ORT-MECATRONICA/TP-Integrador-Mastrangelo-Wiemeyer-Martos-Bae/Presentacion huerta.pdf

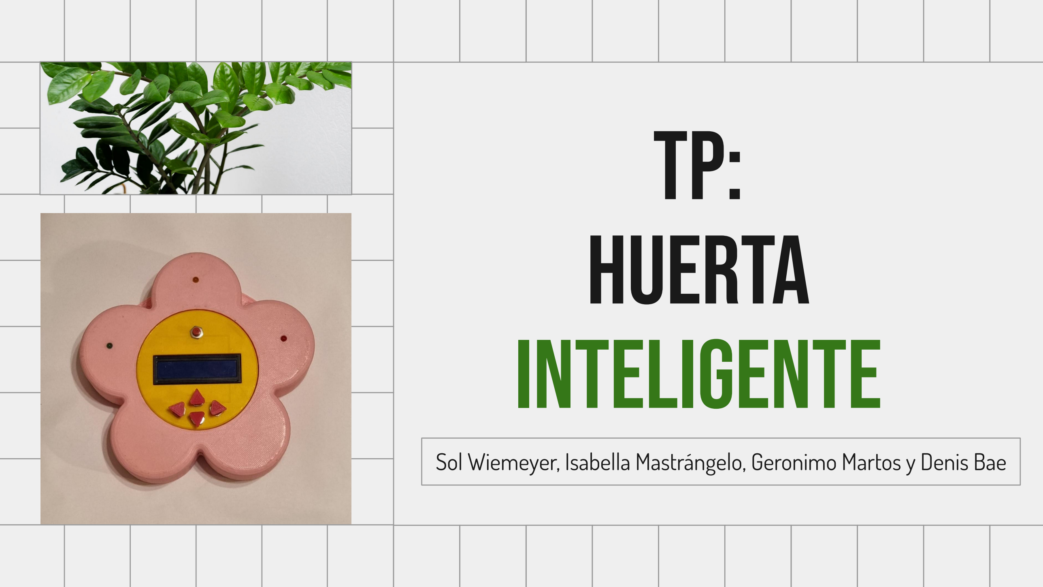
[picture p1: figure]
TP: Huerta inteligente

Sol Wiemeyer, Isabella Mastrángelo, Geronimo Martos y Denis Bae

# Problemática a resolver y usuario

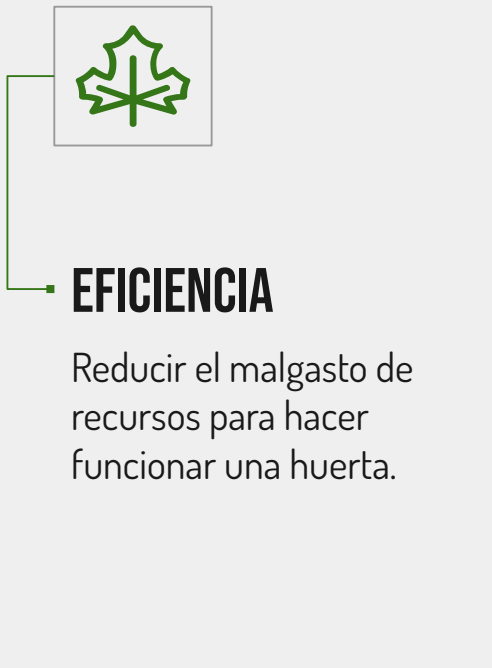
[picture p2: figure]
Reducir el malgasto de recursos para hacer funcionar una huerta.; Eficiencia
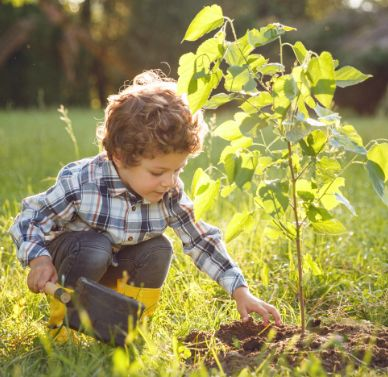
[picture p3: figure]

Su diseño, comodidad y
facilidad para ser utilizado lo hacen un producto
usable por un gran
público

## Disponibilidad

# Funciones

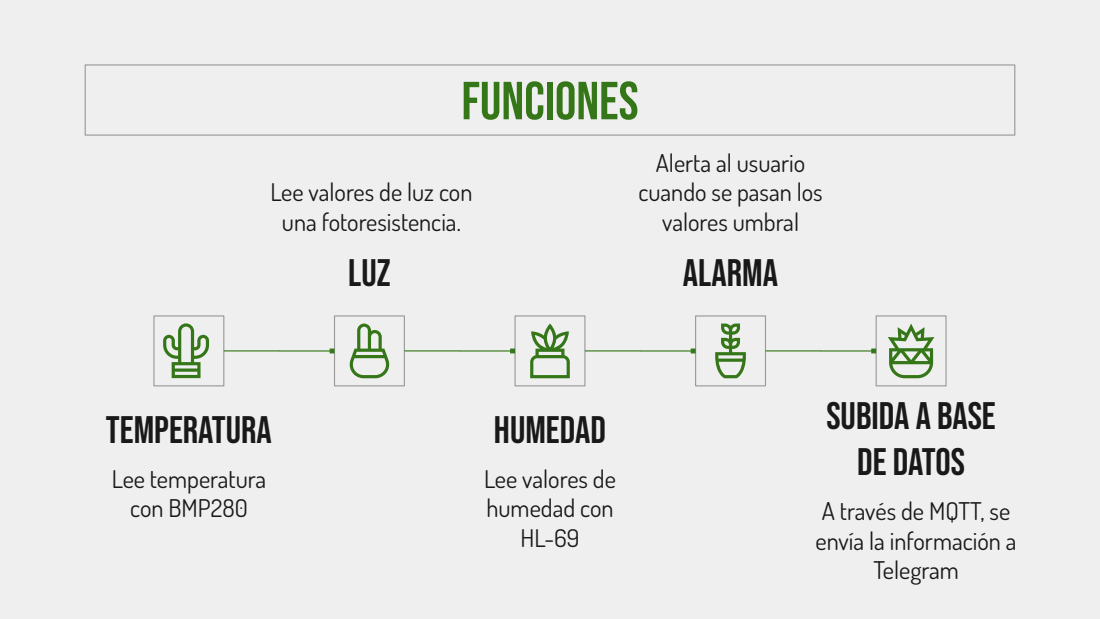
[picture p4: page 3]
Lee temperatura con BMP280; Temperatura

Alerta al usuario
cuando se pasan los
valores umbral
Alarma

Lee valores de luz con
una fotoresistencia.
Luz

Subida a base
de datos
A través de MQTT, se
envía la información a
Telegram

Humedad
Lee valores de
humedad con

# Maquina de estados

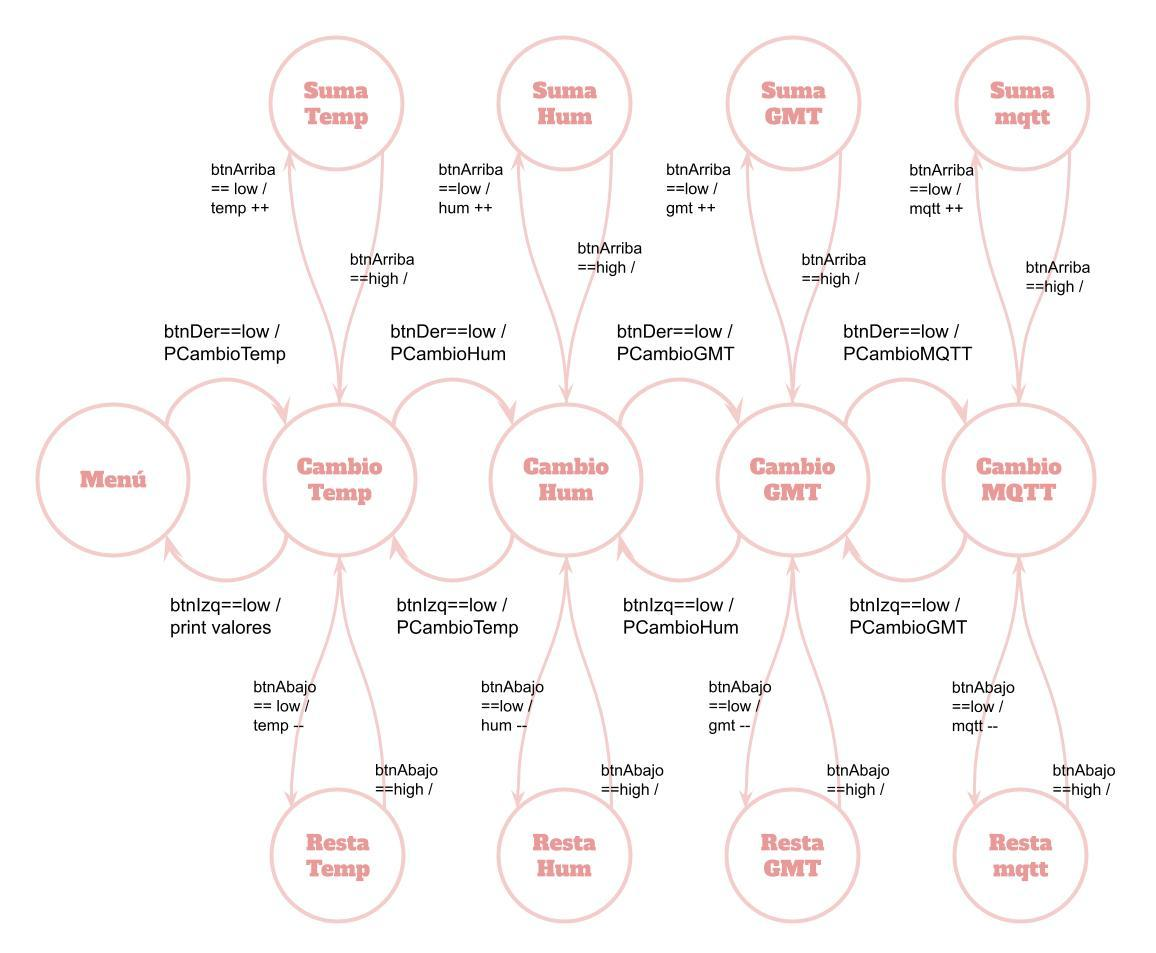
[picture p5: figure]

# Diseño

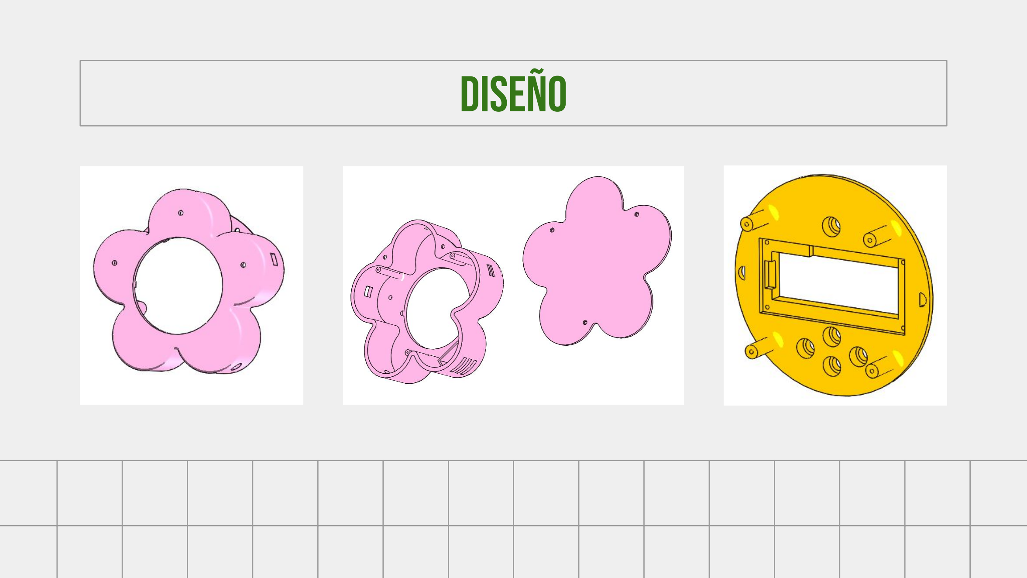
[picture p6: page 5]

# Conexiones microcontrolador

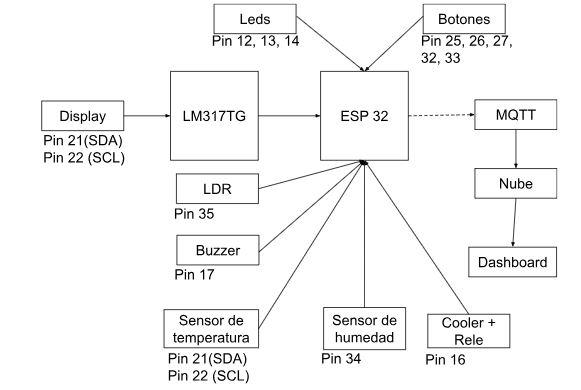
[picture p7: figure]

# Problemas

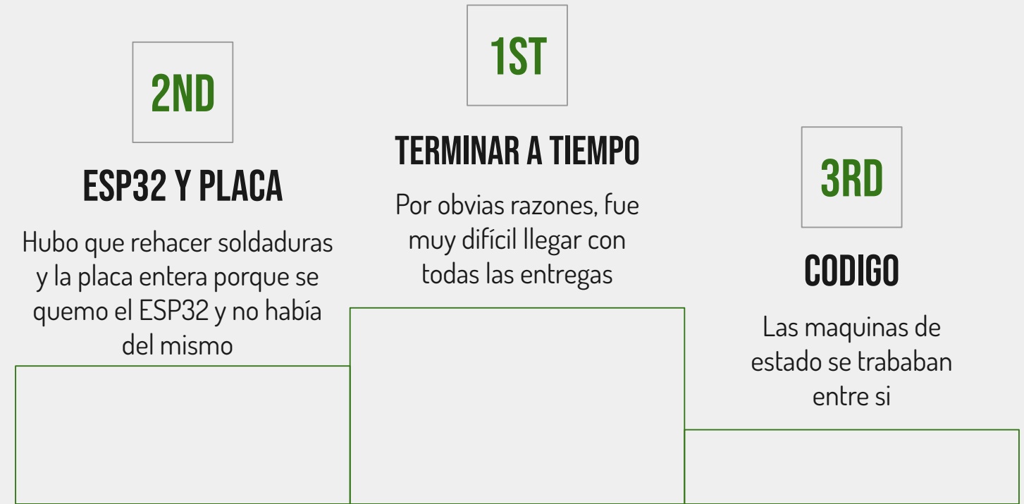
[picture p8: figure]
Codigo; Las maquinas de estado se trababan entre si; 3rd Terminar a tiempo; Por obvias razones, fue muy difícil llegar con todas las entregas; Esp32 y placa; Hubo que rehacer soldaduras y la placa entera porque se quemo el ESP32 y no había del mismo

# FIn
