ORT-MECATRONICA/TP-Integrador-Mastrangelo-Wiemeyer-Martos-Bae/Maquinas-de-estados/MaquinaEstadosHuerta2.jpg

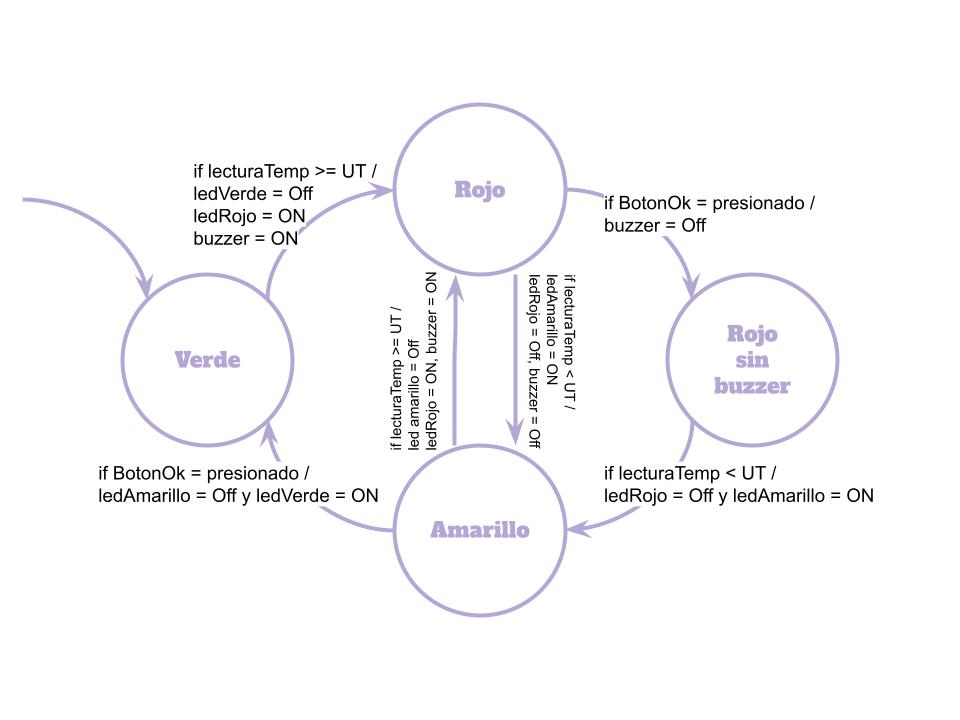
Maquinas-de-estados/MaquinaEstadosHuerta2.jpg
