ORT-MECATRONICA/TP-Integrador-Mastrangelo-Wiemeyer-Martos-Bae/Placa/esquematico.PNG

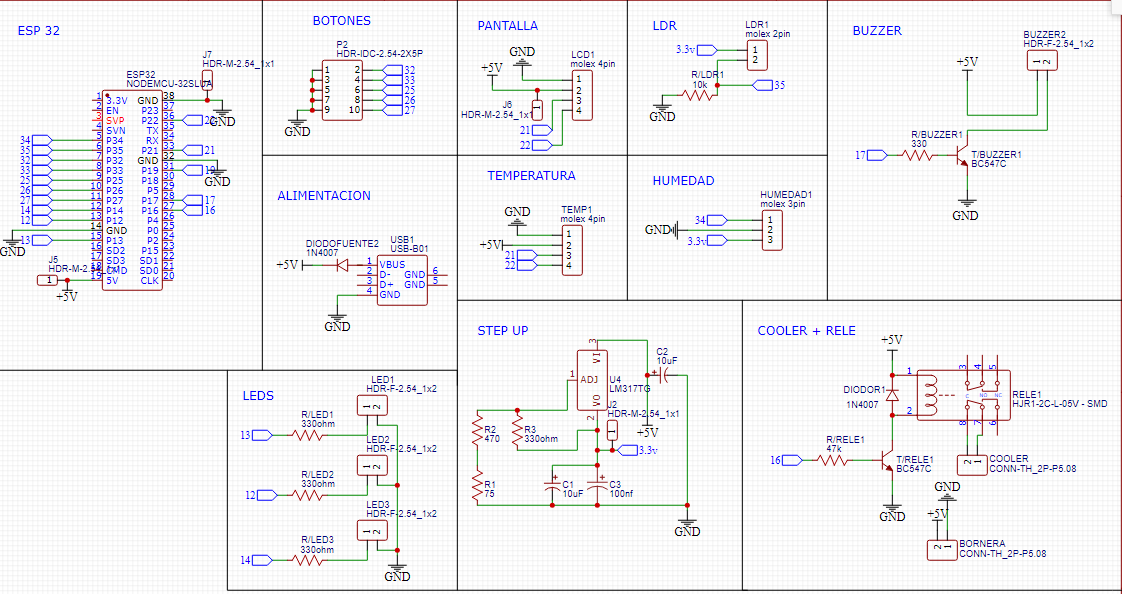
Placa/esquematico.PNG
