ORT-MECATRONICA/TP-Integrador-Mastrangelo-Wiemeyer-Martos-Bae/Placa/pcb.PNG

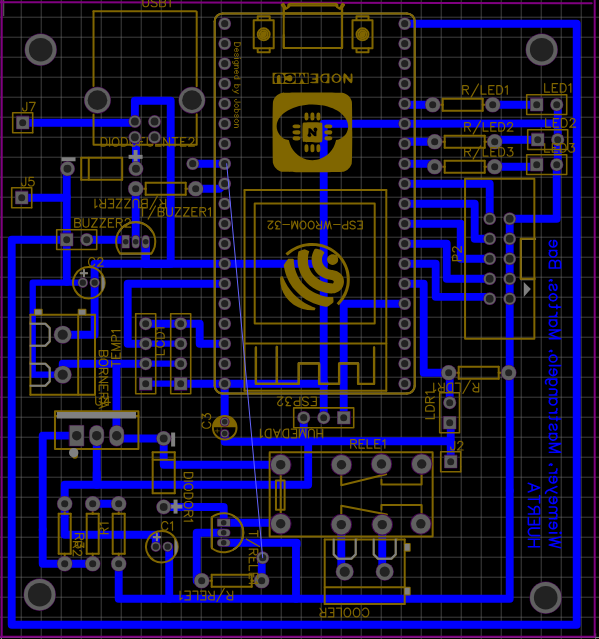
Placa/pcb.PNG
