ORT-MECATRONICA/TP-Integrador-Mastrangelo-Wiemeyer-Martos-Bae/Huerta de mirko.STL

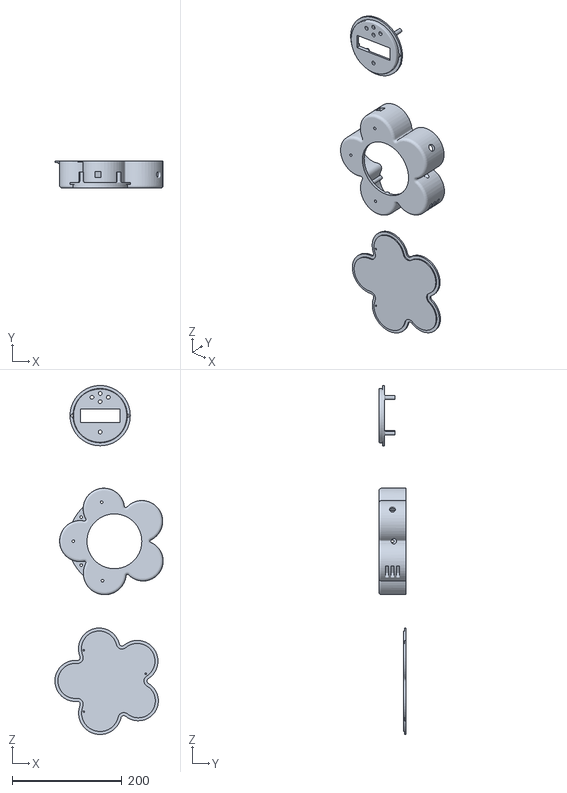
[picture p12: CAD file, 2023-11-17]
Huerta de mirko.STL
197.5 x 50.0 x 636.7
