ORT-MECATRONICA/TP-Integrador-Mastrangelo-Wiemeyer-Martos-Bae/Códigos de prueba/Prueba_Display_16x2_HelloWorld.ino

#include <LiquidCrystal_I2C.h>

int lcdColumns = 16;
int lcdRows = 2;

LiquidCrystal_I2C lcd(0x27, lcdColumns, lcdRows);  

void setup(){
  lcd.begin();                 
  lcd.backlight();
}

void loop(){
  lcd.setCursor(0, 0);
  lcd.print("Hello, World!");
  delay(1000);
  lcd.clear();
  lcd.setCursor(0,1);
  lcd.print("Hello, World!");
  delay(1000);
  lcd.clear(); 
}
