ORT-MECATRONICA/TP-Integrador-Mastrangelo-Wiemeyer-Martos-Bae/(commit log)

2023-07-07 Sensor de Humedad
2023-07-07 Boton Led Buzzer
